daveyboy17/Cell-Top-Monitor/v2/README.md

This is the new improved version that allows separate retrieval of the voltages or temperatures.
It will default to voltages, but only after it has received a seeding message for separate data, otherwise it will operate in combined data.
