daveyboy17/Cell-Top-Monitor/Docs/DTCM10D48--1000-R01 S01.pdf

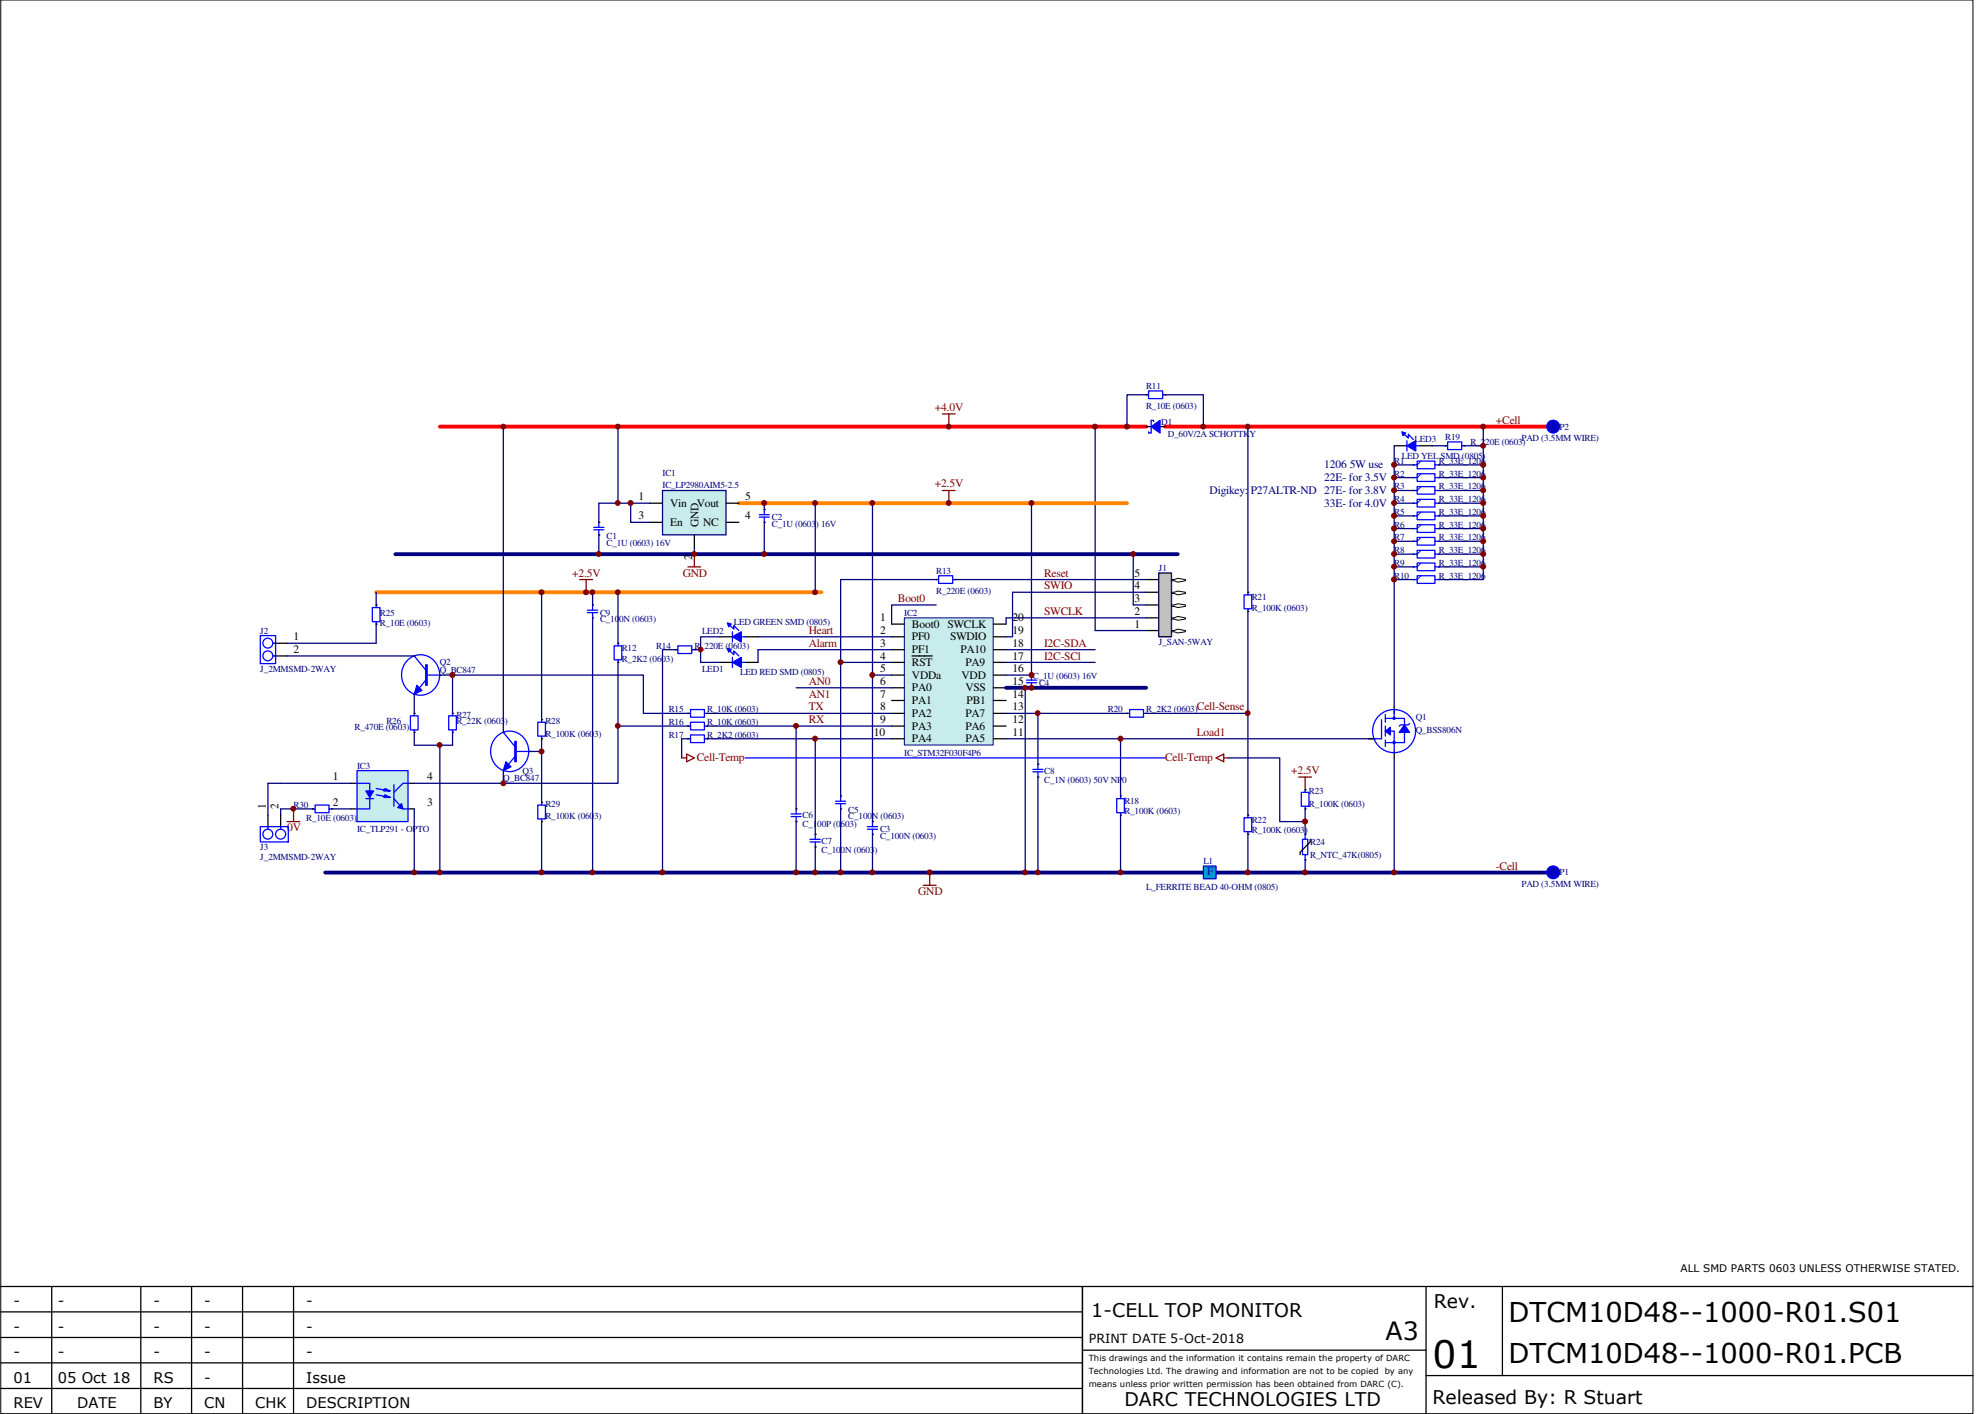
[picture p4: page 1]

ALL SMD PARTS 0603 UNLESS OTHERWISE STATED.

This drawings and the information it contains remain the property of DARC
Technologies Ltd. The drawing and information are not to be copied by any
means unless prior written permission has been obtained from DARC (C).
DARC TECHNOLOGIES LTD
