daveyboy17/Cell-Top-Monitor/Docs/OS CT BMS Sch.pdf

D

1 | 2 | 3 | 4

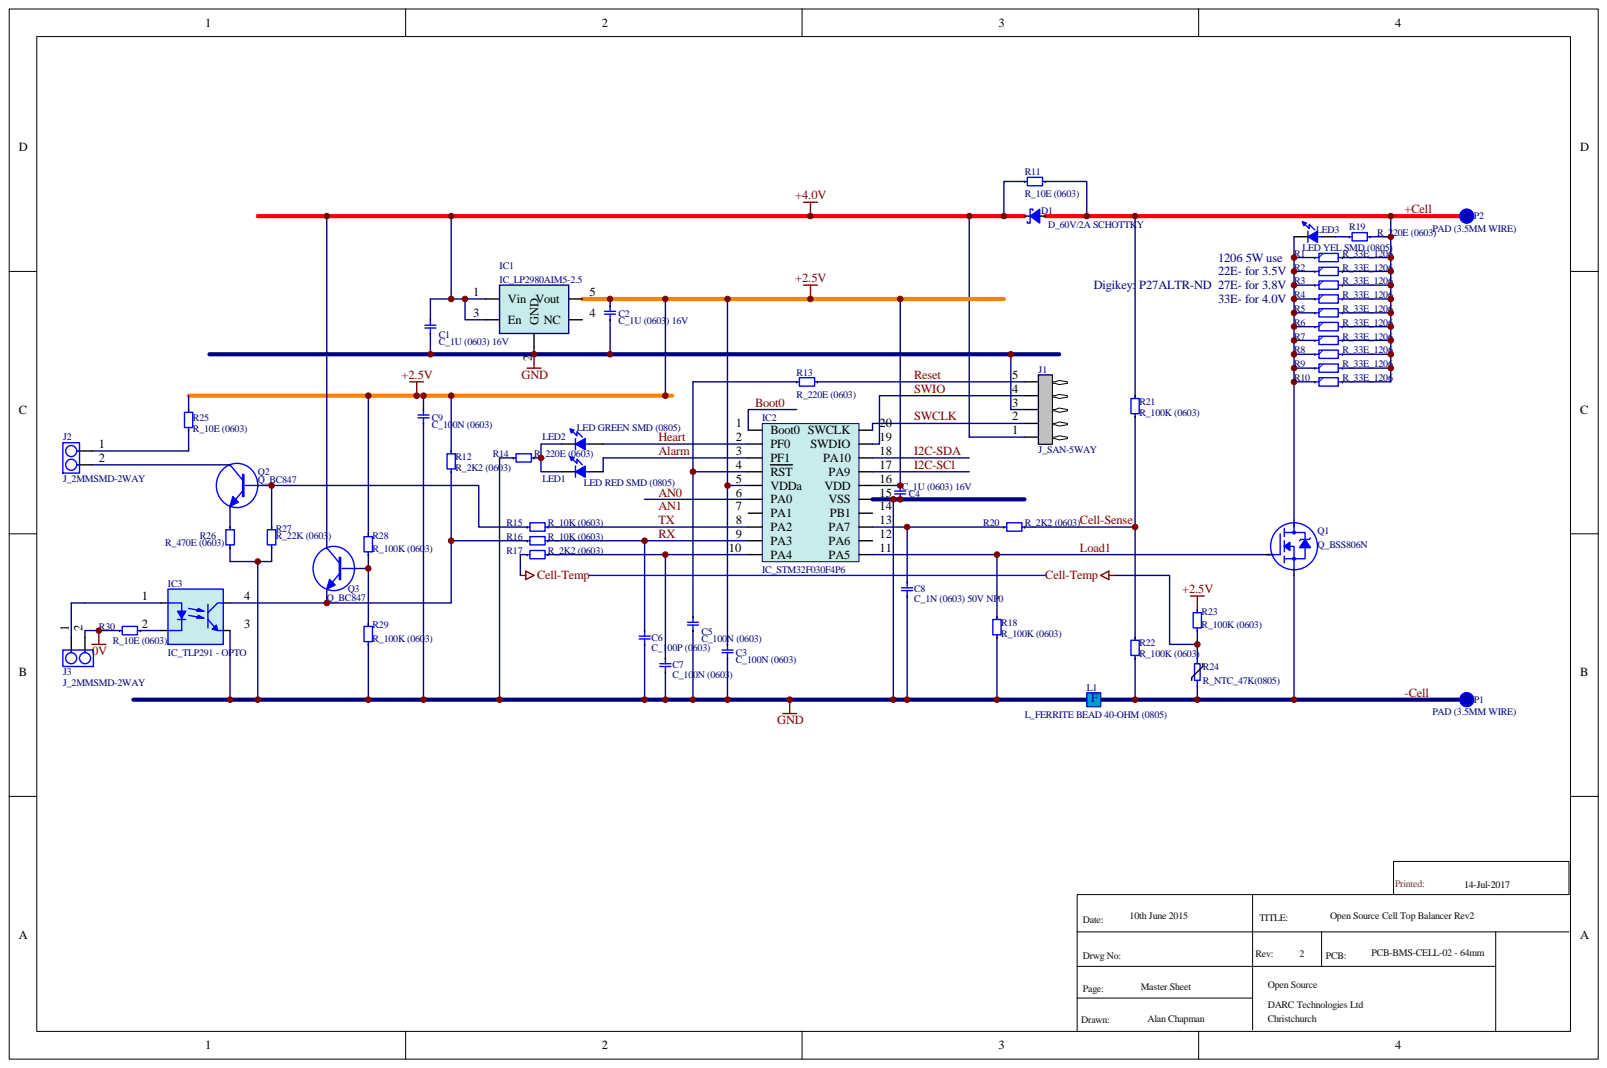
[picture p5: page 1]

Open Source Cell Top Balancer Rev2
