daveyboy17/Cell-Top-Monitor/(list of files, drawings)

Other design files:
Docs/DTCM10D48--1000-R01.PCB
