daveyboy17/Cell-Top-Monitor/v2/main.h

/***********************************************************
    Filename:	main.h
    Author:		David Burkitt
    Date:		2 April, 2015

    Changes:
***********************************************************/


#ifndef MAIN_H_INCLUDED
#define MAIN_H_INCLUDED


#define BAUDRATE			(19200)
//#define BAUDRATE			(9600)							// hardware on early proto's couldn't hack it at 19200

#define DYNAMIC_BALANCING	(0)								// 0 = Top balancing only, 1 = balance if > mean + 50mV.

#define INTERVAL_SECONDS	(2)								// 2-59 - sample the cell every x seconds. NOTE: need to adjust the Watchdog interval as well.
#define AUTOSEND_SECONDS	(30)							// time to wait after last message before sending unheeded.
#define UART_SLEEP_MS		(5) //(10)

#define TYPE_BOTH			(0)
#define TYPE_VOLTAGE_ONLY	(1)
#define TYPE_TEMP_ONLY		(2)


void			fv_USART1_send(uint16_t u16_num_bytes, uint8_t u8a_source[]);


#endif // MAIN_H_INCLUDED
