daveyboy17/Cell-Top-Monitor/v2/temperature.h

/***********************************************************
	@file		temperature.h
    @author		David Burkitt
    @date		10 June, 2015
 **********************************************************/


#ifndef TEMPERTURE_H_INCLUDED
#define TEMPERTURE_H_INCLUDED


int16_t	fs16_temperature_convert(uint16_t u16_adc);


#endif	// TEMPERTURE_H_INCLUDED
