daveyboy17/Cell-Top-Monitor/(commit log)

2017-03-19 Add files via upload
    Code for v2.0 boards with comms at 9600 baud
2017-08-02 updated to reflect current direction
2017-08-25 added calibration process
2020-08-04 PCB design files added
    [DTCM10D48--1000-R01.PCB]
